whatnick/atm90e26_breakout_kicad/README.md

# ATM90E26 Breakout

This is a breakout board for hobbyists and experimenters who would like to get used to this metering grade energy monitoring ASIC in the breadboard context using voltage and current transformers as inputs.

## Where to obtain the PCB

Pre-built PCB's can be obtained from.

- [Tindie](https://www.tindie.com/products/whatnick/atm90e26-breakout/)
- [Elecrow](https://www.elecrow.com/atm90e26-breakout.html)
- [PCBWay](https://www.pcbway.com/project/gifts_detail/ATM90E26_Breakout.html)
