whatnick/atm90e26_breakout_kicad/bom/atm90e26_breakout_bom.xlsx

Reference | QTY | Value | Package | Manufacturer Part number | Original
C11, C12 | 2 | 27p | C_0603_1608Metric | 06035A270JAT2A | N
C2, C6, C9 | 3 | 100n | C_0603_1608Metric | 06035C104KAT2A | N
C4, C5, C10, C13 | 4 | 33n | C_0603_1608Metric | 06035C333KAT2A | N
C3, C7 | 2 | 330n | C_0603_1608Metric | 0603YD334KAT2A | N
C1, C8 | 2 | 10uf | CP_EIA-2012-15_AVX-P | TAJA106K016HNJ | N
R1, R5 | 2 | 100R | R_0603_1608Metric | RC0603FR-07100RL | N
R2, R3, R6, R9 | 4 | 1K | R_0603_1608Metric | RC0603FR-071KL | N
R7, R8 | 2 | 2.4R | R_0603_1608Metric | RC0603FR-072R4L | N
R4 | 1 | 0R | R_0603_1608Metric | RC0603JR-070RL | N
U1 | 1 | ATM90E26 | SSOP-28_5.3x10.2mm_P0.65mm | ATM90E26-YU-B | Y
Q1 | 1 | 8.192MHz | Crystal_SMD_HC49-SD | ABLS3-8.192MHZ-D4Y-T | Y
