whatnick/atm90e26_breakout_kicad/(commit log)

2020-12-06 Initial import
    [ATM90E26_Breakout.kicad_pcb, ATM90E26_Breakout.kicad_sch]
2020-12-07 More porting WIP
    [ATM90E26_Breakout.kicad_pcb, ATM90E26_Breakout.kicad_sch]
2020-12-12 Continue port by replacing Eagle parts with KiCAD ones
    [ATM90E26_Breakout.kicad_pcb, ATM90E26_Breakout.kicad_sch]
2020-12-12 Save some libe changes
    [ATM90E26_Breakout.kicad_pcb]
2020-12-13 Complete routing
    [ATM90E26_Breakout.kicad_pcb, ATM90E26_Breakout.kicad_sch]
2020-12-13 Update BOM
    [ATM90E26_Breakout.kicad_pcb, ATM90E26_Breakout.kicad_sch]
2020-12-13 Add gerbers
    [ATM90E26_Breakout-B_Mask.gbs, ATM90E26_Breakout-B_Paste.gbp, ATM90E26_Breakout-B_Silkscreen.gbo, ATM90E26_Breakout-Bottom.gbl, ATM90E26_Breakout-Edge_Cuts.gm1, ATM90E26_Breakout-F_Mask.gts, ATM90E26_Breakout-F_Paste.gtp, ATM90E26_Breakout-F_Silkscreen.gto]
2023-07-23 Add bom
    [atm90e26_breakout_bom.xlsx]
2023-07-23 Update to Elecrow template
    [atm90e26_breakout_bom.xlsx]
2023-07-23 Upgrade PCB to KiCAD 7.0
    [ATM90E26_Breakout.kicad_pcb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]
2024-12-23 Update format for files
    [ATM90E26_Breakout.kicad_pcb, ATM90E26_Breakout.kicad_sch]
